infinitymakerspace/TommyPROM/hardware/TommyPROM-uno.sch

## EAGLE design hardware/TommyPROM-uno.sch (2019-01-26)

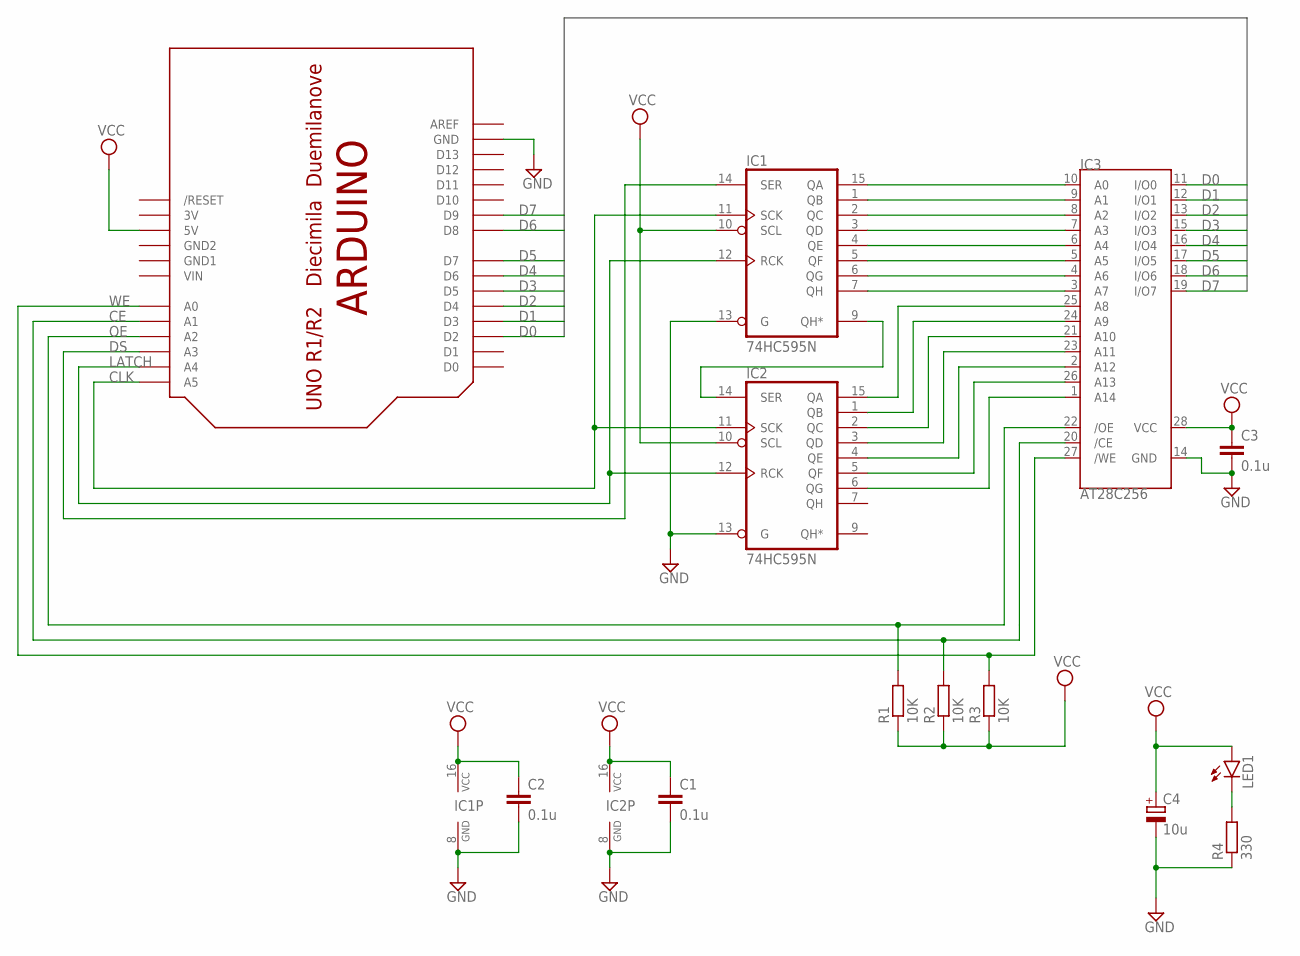
[picture p4: schematic TommyPROM-uno.sch]

Parts:
C1, C2, C3: 0.1u; C025-025X050
C4: 10u; E2-5
IC1, IC2: 74HC595N; DIL16
IC3: AT28C256; DIL28-6
LED1: LED5MM
R1, R2, R3: 10K; 0204/7
R4: 330; 0204/7
U$1: ARDUINO-BPLACE

Connections:
CE: IC3.20 (/CE), R2.2, U$1.A1
CLK: IC1.11 (SCK), IC2.11 (SCK), U$1.A5
D0: IC3.11 (I/O0), U$1.D2
D1: IC3.12 (I/O1), U$1.D3
D2: IC3.13 (I/O2), U$1.D4
D3: IC3.15 (I/O3), U$1.D5
D4: IC3.16 (I/O4), U$1.D6
D5: IC3.17 (I/O5), U$1.D7
D6: IC3.18 (I/O6), U$1.D8
D7: IC3.19 (I/O7), U$1.D9
DS: IC1.14 (SER), U$1.A3
GND: C1.2, C2.2, C3.2, C4.-, IC1.8 (GND), IC1.13 (G), IC2.8 (GND), IC2.13 (G), IC3.14 (GND), R4.1, U$1.GND
LATCH: IC1.12 (RCK), IC2.12 (RCK), U$1.A4
unnamed: IC1.9 (QH*), IC2.14 (SER)
unnamed: LED1.K (C), R4.2
unnamed: IC2.6 (QG), IC3.1 (A14)
unnamed: IC2.5 (QF), IC3.26 (A13)
unnamed: IC2.4 (QE), IC3.2 (A12)
unnamed: IC2.3 (QD), IC3.23 (A11)
unnamed: IC2.2 (QC), IC3.21 (A10)
unnamed: IC2.1 (QB), IC3.24 (A9)
unnamed: IC2.15 (QA), IC3.25 (A8)
unnamed: IC1.7 (QH), IC3.3 (A7)
unnamed: IC1.6 (QG), IC3.4 (A6)
unnamed: IC1.5 (QF), IC3.5 (A5)
unnamed: IC1.4 (QE), IC3.6 (A4)
unnamed: IC1.3 (QD), IC3.7 (A3)
unnamed: IC1.2 (QC), IC3.8 (A2)
unnamed: IC1.1 (QB), IC3.9 (A1)
unnamed: IC1.15 (QA), IC3.10 (A0)
OE: IC3.22 (/OE), R1.2, U$1.A2
VCC: C1.1, C2.1, C3.1, C4.+, IC1.10 (SCL), IC1.16 (VCC), IC2.10 (SCL), IC2.16 (VCC), IC3.28 (VCC), LED1.A, R1.1, R2.1, R3.1, U$1.5V
WE: IC3.27 (/WE), R3.2, U$1.A0
