infinitymakerspace/TommyPROM/(commit log)

2019-01-26 Modifications to use 74HC595 shift registers instead of the original 74LS164
    [TommyPROM-8755A Nano.sch, TommyPROM-nano.sch, TommyPROM-uno.sch]
2019-02-18 V. 1.7: typo fixes; added 2 LEDs for control status
    [TommyPROM.ino, XModem.cpp, XModem.h]
